justincardoza/pi-security-camera-mk1/(commit log)

2025-09-25 Initial release.
    [case-pi3b-hq-cam.scad]
2025-09-25 Updated license to CC BY-NC-SA.
    [case-pi3b-hq-cam.scad]
2025-09-26 Added Printables link.
